MattisLind/68008ice/kicad/BOM.csv

Reference | Quantity | Value | Footprint | Manufacturer | MPN | LCSC | JLCPCB_library | Assembly | JLCPCB_URL | Verified_date | Selection_reason | Source | Status
C1 | 1 | 15p | Capacitor_SMD:C_0402_1005Metric | FH (Guangdong Fenghua Advanced Tech) | 0402CG150J500NT | C1548 | Basic | JLCPCB_SMT | https://jlcpcb.com/partdetail/0402CG150J500NT/C1548 | 2026-11-09 | Basic C0G crystal load capacitors; both use the same part. | https://www.lcsc.com/datasheet/C1548.pdf | candidate
C2 | 1 | 15p | Capacitor_SMD:C_0402_1005Metric | FH (Guangdong Fenghua Advanced Tech) | 0402CG150J500NT | C1548 | Basic | JLCPCB_SMT | https://jlcpcb.com/partdetail/0402CG150J500NT/C1548 | 2026-11-09 | Basic C0G crystal load capacitors; both use the same part. | https://www.lcsc.com/datasheet/C1548.pdf | candidate
C4 | 1 | 10u | Capacitor_SMD:C_0805_2012Metric | Samsu | CL21A106KAYNNNE | C15850 | Basic | JLCPCB_SMT | https://jlcpcb.com/partdetail/CL21A106KAYNNNE/C15850 | 2026-11-09 | Basic 25V X5R for LDO input/output; same exact part. | https://www.lcsc.com/datasheet/C15850.pdf | candidate
C5 | 1 | 10u | Capacitor_SMD:C_0805_2012Metric | Samsu | CL21A106KAYNNNE | C15850 | Basic | JLCPCB_SMT | https://jlcpcb.com/partdetail/CL21A106KAYNNNE/C15850 | 2026-11-09 | Basic 25V X5R for LDO input/output; same exact part. | https://www.lcsc.com/datasheet/C15850.pdf | candidate
C6 | 1 | 4.7u | Capacitor_SMD:C_0402_1005Metric | Samsung Electro-Mechanics | CL05A475MP5NRNC | C23733 | Basic | JLCPCB_SMT | https://jlcpcb.com/partdetail/CL05A475MP5NRNC/C23733 | 2026-11-09 | Basic 10V X5R; share core/filter and PSRAM local bypass value; verify effective capacitance, including at least 1uF at PSRAM VDD. | https://www.lcsc.com/datasheet/C23733.pdf | candidate
C7 | 1 | 4.7u | Capacitor_SMD:C_0402_1005Metric | Samsung Electro-Mechanics | CL05A475MP5NRNC | C23733 | Basic | JLCPCB_SMT | https://jlcpcb.com/partdetail/CL05A475MP5NRNC/C23733 | 2026-11-09 | Basic 10V X5R; share core/filter and PSRAM local bypass value; verify effective capacitance, including at least 1uF at PSRAM VDD. | https://www.lcsc.com/datasheet/C23733.pdf | candidate
C8 | 1 | 4.7u | Capacitor_SMD:C_0402_1005Metric | Samsung Electro-Mechanics | CL05A475MP5NRNC | C23733 | Basic | JLCPCB_SMT | https://jlcpcb.com/partdetail/CL05A475MP5NRNC/C23733 | 2026-11-09 | Basic 10V X5R; share core/filter and PSRAM local bypass value; verify effective capacitance, including at least 1uF at PSRAM VDD. | https://www.lcsc.com/datasheet/C23733.pdf | candidate
C9 | 1 | 100n | Capacitor_SMD:C_0402_1005Metric | Samsung Electro-Mechanics | CL05B104KO5NNNC | C1525 | Basic | JLCPCB_SMT | https://jlcpcb.com/partdetail/CL05B104KO5NNNC/C1525 | 2026-11-09 | Basic common MCU, PSRAM and connector high-frequency bypass part. | https://www.lcsc.com/datasheet/C1525.pdf | candidate
C10 | 1 | 100n | Capacitor_SMD:C_0402_1005Metric | Samsung Electro-Mechanics | CL05B104KO5NNNC | C1525 | Basic | JLCPCB_SMT | https://jlcpcb.com/partdetail/CL05B104KO5NNNC/C1525 | 2026-11-09 | Basic common MCU, PSRAM and connector high-frequency bypass part. | https://www.lcsc.com/datasheet/C1525.pdf | candidate
C11 | 1 | 100n | Capacitor_SMD:C_0402_1005Metric | Samsung Electro-Mechanics | CL05B104KO5NNNC | C1525 | Basic | JLCPCB_SMT | https://jlcpcb.com/partdetail/CL05B104KO5NNNC/C1525 | 2026-11-09 | Basic common MCU, PSRAM and connector high-frequency bypass part. | https://www.lcsc.com/datasheet/C1525.pdf | candidate
C12 | 1 | 100n | Capacitor_SMD:C_0402_1005Metric | Samsung Electro-Mechanics | CL05B104KO5NNNC | C1525 | Basic | JLCPCB_SMT | https://jlcpcb.com/partdetail/CL05B104KO5NNNC/C1525 | 2026-11-09 | Basic common MCU, PSRAM and connector high-frequency bypass part. | https://www.lcsc.com/datasheet/C1525.pdf | candidate
C13 | 1 | 100n | Capacitor_SMD:C_0402_1005Metric | Samsung Electro-Mechanics | CL05B104KO5NNNC | C1525 | Basic | JLCPCB_SMT | https://jlcpcb.com/partdetail/CL05B104KO5NNNC/C1525 | 2026-11-09 | Basic common MCU, PSRAM and connector high-frequency bypass part. | https://www.lcsc.com/datasheet/C1525.pdf | candidate
C14 | 1 | 100n | Capacitor_SMD:C_0402_1005Metric | Samsung Electro-Mechanics | CL05B104KO5NNNC | C1525 | Basic | JLCPCB_SMT | https://jlcpcb.com/partdetail/CL05B104KO5NNNC/C1525 | 2026-11-09 | Basic common MCU, PSRAM and connector high-frequency bypass part. | https://www.lcsc.com/datasheet/C1525.pdf | candidate
C15 | 1 | 100n | Capacitor_SMD:C_0402_1005Metric | Samsung Electro-Mechanics | CL05B104KO5NNNC | C1525 | Basic | JLCPCB_SMT | https://jlcpcb.com/partdetail/CL05B104KO5NNNC/C1525 | 2026-11-09 | Basic common MCU, PSRAM and connector high-frequency bypass part. | https://www.lcsc.com/datasheet/C1525.pdf | candidate
C16 | 1 | 100n | Capacitor_SMD:C_0402_1005Metric | Samsung Electro-Mechanics | CL05B104KO5NNNC | C1525 | Basic | JLCPCB_SMT | https://jlcpcb.com/partdetail/CL05B104KO5NNNC/C1525 | 2026-11-09 | Basic common MCU, PSRAM and connector high-frequency bypass part. | https://www.lcsc.com/datasheet/C1525.pdf | candidate
C17 | 1 | 100n | Capacitor_SMD:C_0402_1005Metric | Samsung Electro-Mechanics | CL05B104KO5NNNC | C1525 | Basic | JLCPCB_SMT | https://jlcpcb.com/partdetail/CL05B104KO5NNNC/C1525 | 2026-11-09 | Basic common MCU, PSRAM and connector high-frequency bypass part. | https://www.lcsc.com/datasheet/C1525.pdf | candidate
C18 | 1 | 100n | Capacitor_SMD:C_0402_1005Metric | Samsung Electro-Mechanics | CL05B104KO5NNNC | C1525 | Basic | JLCPCB_SMT | https://jlcpcb.com/partdetail/CL05B104KO5NNNC/C1525 | 2026-11-09 | Basic common MCU, PSRAM and connector high-frequency bypass part. | https://www.lcsc.com/datasheet/C1525.pdf | candidate
C19 | 1 | 100n | Capacitor_SMD:C_0402_1005Metric | Samsung Electro-Mechanics | CL05B104KO5NNNC | C1525 | Basic | JLCPCB_SMT | https://jlcpcb.com/partdetail/CL05B104KO5NNNC/C1525 | 2026-11-09 | Basic common MCU, PSRAM and connector high-frequency bypass part. | https://www.lcsc.com/datasheet/C1525.pdf | candidate
C20 | 1 | 100n | Capacitor_SMD:C_0402_1005Metric | Samsung Electro-Mechanics | CL05B104KO5NNNC | C1525 | Basic | JLCPCB_SMT | https://jlcpcb.com/partdetail/CL05B104KO5NNNC/C1525 | 2026-11-09 | Basic common MCU, PSRAM and connector high-frequency bypass part. | https://www.lcsc.com/datasheet/C1525.pdf | candidate
C21 | 1 | 100n | Capacitor_SMD:C_0402_1005Metric | Samsung Electro-Mechanics | CL05B104KO5NNNC | C1525 | Basic | JLCPCB_SMT | https://jlcpcb.com/partdetail/CL05B104KO5NNNC/C1525 | 2026-11-09 | Basic common MCU, PSRAM and connector high-frequency bypass part. | https://www.lcsc.com/datasheet/C1525.pdf | candidate
C22 | 1 | 100n | Capacitor_SMD:C_0402_1005Metric | Samsung Electro-Mechanics | CL05B104KO5NNNC | C1525 | Basic | JLCPCB_SMT | https://jlcpcb.com/partdetail/CL05B104KO5NNNC/C1525 | 2026-11-09 | Basic common MCU, PSRAM and connector high-frequency bypass part. | https://www.lcsc.com/datasheet/C1525.pdf | candidate
D1 | 1 | BAT54X | Diode_SMD:D_SOD-523 | R+O | BAT54X | C19627026 | Extended | JLCPCB_SMT | https://jlcpcb.com/partdetail/BAT54X/C19627026 | 2026-11-10 | User-selected Extended SMT R+O BAT54X / C19627026, SOD-523, 30V/200mA. Five identical upper clamps; pad 1 cathode to 3V3, pad 2 anode at the protected MCU node. Retain the accepted sub-mA forward-voltage margin and nominal proxy-model SPICE evidence. | https://datasheet.lcsc.com/datasheet/pdf/cb06a61a226c47be2923522f1be7f66a.pdf?productCode=C19627026 | accepted_BAT54_voltage_margin_risk
D2 | 1 | BAT54X | Diode_SMD:D_SOD-523 | R+O | BAT54X | C19627026 | Extended | JLCPCB_SMT | https://jlcpcb.com/partdetail/BAT54X/C19627026 | 2026-11-10 | User-selected Extended SMT R+O BAT54X / C19627026, SOD-523, 30V/200mA. Five identical upper clamps; pad 1 cathode to 3V3, pad 2 anode at the protected MCU node. Retain the accepted sub-mA forward-voltage margin and nominal proxy-model SPICE evidence. | https://datasheet.lcsc.com/datasheet/pdf/cb06a61a226c47be2923522f1be7f66a.pdf?productCode=C19627026 | accepted_BAT54_voltage_margin_risk
D3 | 1 | BAT54X | Diode_SMD:D_SOD-523 | R+O | BAT54X | C19627026 | Extended | JLCPCB_SMT | https://jlcpcb.com/partdetail/BAT54X/C19627026 | 2026-11-10 | User-selected Extended SMT R+O BAT54X / C19627026, SOD-523, 30V/200mA. Five identical upper clamps; pad 1 cathode to 3V3, pad 2 anode at the protected MCU node. Retain the accepted sub-mA forward-voltage margin and nominal proxy-model SPICE evidence. | https://datasheet.lcsc.com/datasheet/pdf/cb06a61a226c47be2923522f1be7f66a.pdf?productCode=C19627026 | accepted_BAT54_voltage_margin_risk
D4 | 1 | BAT54X | Diode_SMD:D_SOD-523 | R+O | BAT54X | C19627026 | Extended | JLCPCB_SMT | https://jlcpcb.com/partdetail/BAT54X/C19627026 | 2026-11-10 | User-selected Extended SMT R+O BAT54X / C19627026, SOD-523, 30V/200mA. Five identical upper clamps; pad 1 cathode to 3V3, pad 2 anode at the protected MCU node. Retain the accepted sub-mA forward-voltage margin and nominal proxy-model SPICE evidence. | https://datasheet.lcsc.com/datasheet/pdf/cb06a61a226c47be2923522f1be7f66a.pdf?productCode=C19627026 | accepted_BAT54_voltage_margin_risk
D5 | 1 | BAT54X | Diode_SMD:D_SOD-523 | R+O | BAT54X | C19627026 | Extended | JLCPCB_SMT | https://jlcpcb.com/partdetail/BAT54X/C19627026 | 2026-11-10 | User-selected Extended SMT R+O BAT54X / C19627026, SOD-523, 30V/200mA. Five identical upper clamps; pad 1 cathode to 3V3, pad 2 anode at the protected MCU node. Retain the accepted sub-mA forward-voltage margin and nominal proxy-model SPICE evidence. | https://datasheet.lcsc.com/datasheet/pdf/cb06a61a226c47be2923522f1be7f66a.pdf?productCode=C19627026 | accepted_BAT54_voltage_margin_risk
J1 | 1 | CPU TOP SOCKET - MECHANICAL TBD |  | TBD | TBD |  |  | Manual |  |  | Top/bottom DIP contacts assembled manually; excluded from JLCPCB selection. | https://www.nxp.com/docs/en/reference-manual/MC68000UM.pdf | unresolved_connector_no_footprint
J2 | 1 | TARGET BOTTOM PLUG - MECHANICAL TBD |  | TBD | TBD |  |  | Manual |  |  | Top/bottom DIP contacts assembled manually; excluded from JLCPCB selection. | https://www.nxp.com/docs/en/reference-manual/MC68000UM.pdf | unresolved_connector_no_footprint
J3 | 1 | USB4105-GF-A | Connector_USB:USB_C_Receptacle_GCT_USB4105-xx-A_16P_TopMnt_Horizontal | Global Connector Technology | USB4105-GF-A | C3020560 | Extended | JLCPCB_SMT | https://jlcpcb.com/partdetail/USB4105-GF-A/C3020560 | 2026-11-09 | Extended: retain documented USB-C SMT-contact connector/footprint; alternative C165948 is also Extended. Shell stakes require placement review. | https://www.lcsc.com/datasheet/C3020560.pdf | candidate_verify_stake_option
J4 | 1 | SWD JST-SH | Connector_JST:JST_SH_SM03B-SRSS-TB_1x03-1MP_P1.00mm_Horizontal | JST | SM03B-SRSS-TB(LF)(SN) | C160403 | Extended | JLCPCB_SMT | https://jlcpcb.com/partdetail/JST-SM03B_SRSS_TB_LF_SN/C160403 | 2026-11-10 | Extended SMT genuine JST-SH 3-pin 1.0mm-pitch side-entry header, matching the Raspberry Pi Debug Probe supplied cable. Pins 1 SWCLK, 2 GND, 3 SWDIO; metal mounting pads to GND. Selected instead of probe pads; no qualified Basic mating-equivalent was established. Verify board-end cable access and CPU/socket clearance during placement. | https://www.jst-mfg.com/product/pdf/eng/eSH.pdf | candidate_verify_connector_access_and_CPU_clearance
JP1 | 1 | ACTIVE PERMIT - solder bridge open=PASSIVE |  | PCB copper | PCB_FEATURE |  |  | PCB_feature |  |  | PCB copper/pad feature; no purchased component. |  | PCB_solder_bridge_geometry_pending
L1 | 1 | 3.3u AOTA-B201610S3R3-101-T | rp2350_ice:AOTA-B201610S3R3-101-T | Abracon LLC | AOTA-B201610S3R3-101-T | C42411119 | Extended | JLCPCB_SMT | https://jlcpcb.com/partdetail/AOTA-B201610S3R3-101-T/C42411119 | 2026-11-09 | Extended: preserve validated reference core-regulator inductor, current ratings and orientation mark; generic same inductance is insufficient. | https://www.lcsc.com/datasheet/C42411119.pdf | candidate
Q1 | 1 | 2N7002 | Package_TO_SOT_SMD:SOT-23 | Jiangsu Changjing Electronics Technology Co., Ltd. | 2N7002 | C8545 | Basic | JLCPCB_SMT | https://jlcpcb.com/partdetail/2N7002/C8545 | 2026-11-09 | Basic 2N7002 for isolated VBUS presence detection. | https://www.lcsc.com/datasheet/C8545.pdf | candidate
R1 | 1 | 1k | Resistor_SMD:R_0402_1005Metric | UNI-ROYAL(Uniroyal Elec) | 0402WGF1001TCE | C11702 | Basic | JLCPCB_SMT | https://jlcpcb.com/partdetail/0402WGF1001TCE/C11702 | 2026-11-09 | Basic: share crystal/BOOTSEL series, two rail loads and strong PSRAM CS1 pull-up. | https://www.lcsc.com/datasheet/C11702.pdf | candidate
R2 | 1 | 1k | Resistor_SMD:R_0402_1005Metric | UNI-ROYAL(Uniroyal Elec) | 0402WGF1001TCE | C11702 | Basic | JLCPCB_SMT | https://jlcpcb.com/partdetail/0402WGF1001TCE/C11702 | 2026-11-09 | Basic: share crystal/BOOTSEL series, two rail loads and strong PSRAM CS1 pull-up. | https://www.lcsc.com/datasheet/C11702.pdf | candidate
R3 | 1 | 10k | Resistor_SMD:R_0402_1005Metric | UNI-ROYAL(Uniroyal Elec) | 0402WGF1002TCE | C25744 | Basic | JLCPCB_SMT | https://jlcpcb.com/partdetail/0402WGF1002TCE/C25744 | 2026-11-09 | Share RUN pull-up, MODE_PERMIT pull-down, VBUS gate series and detector pull-up. | https://www.lcsc.com/datasheet/C25744.pdf | candidate
R4 | 1 | 1k | Resistor_SMD:R_0402_1005Metric | UNI-ROYAL(Uniroyal Elec) | 0402WGF1001TCE | C11702 | Basic | JLCPCB_SMT | https://jlcpcb.com/partdetail/0402WGF1001TCE/C11702 | 2026-11-09 | Basic: share crystal/BOOTSEL series, two rail loads and strong PSRAM CS1 pull-up. | https://www.lcsc.com/datasheet/C11702.pdf | candidate
R5 | 1 | 10k | Resistor_SMD:R_0402_1005Metric | UNI-ROYAL(Uniroyal Elec) | 0402WGF1002TCE | C25744 | Basic | JLCPCB_SMT | https://jlcpcb.com/partdetail/0402WGF1002TCE/C25744 | 2026-11-09 | Share RUN pull-up, MODE_PERMIT pull-down, VBUS gate series and detector pull-up. | https://www.lcsc.com/datasheet/C25744.pdf | candidate
R6 | 1 | 33 | Resistor_SMD:R_0402_1005Metric | UNI-ROYAL(Uniroyal Elec) | 0402WGF330JTCE | C25105 | Basic | JLCPCB_SMT | https://jlcpcb.com/partdetail/0402WGF330JTCE/C25105 | 2026-11-09 | Basic reference VREG_AVDD filter value; no fee saving justifies changing it to 27 ohm. | https://www.lcsc.com/datasheet/C25105.pdf | candidate
R7 | 1 | 5.1k | Resistor_SMD:R_0402_1005Metric | UNI-ROYAL(Uniroyal Elec) | 0402WGF5101TCE | C25905 | Basic | JLCPCB_SMT | https://jlcpcb.com/partdetail/0402WGF5101TCE/C25905 | 2026-11-09 | Separate USB-C CC Rd resistors; preserve required value. | https://www.lcsc.com/datasheet/C25905.pdf | candidate
R8 | 1 | 5.1k | Resistor_SMD:R_0402_1005Metric | UNI-ROYAL(Uniroyal Elec) | 0402WGF5101TCE | C25905 | Basic | JLCPCB_SMT | https://jlcpcb.com/partdetail/0402WGF5101TCE/C25905 | 2026-11-09 | Separate USB-C CC Rd resistors; preserve required value. | https://www.lcsc.com/datasheet/C25905.pdf | candidate
R9 | 1 | 27 | Resistor_SMD:R_0402_1005Metric | UNI-ROYAL(Uniroyal Elec) | 0402WGF270JTCE | C25100 | Extended | JLCPCB_SMT | https://jlcpcb.com/partdetail/0402WGF270JTCE/C25100 | 2026-11-09 | Extended: keep RP2350 reference USB series termination value; 0603 candidate C25190 is also Extended. Share the exact SKU on D+ and D-. | https://www.lcsc.com/datasheet/C25100.pdf | candidate
R10 | 1 | 27 | Resistor_SMD:R_0402_1005Metric | UNI-ROYAL(Uniroyal Elec) | 0402WGF270JTCE | C25100 | Extended | JLCPCB_SMT | https://jlcpcb.com/partdetail/0402WGF270JTCE/C25100 | 2026-11-09 | Extended: keep RP2350 reference USB series termination value; 0603 candidate C25190 is also Extended. Share the exact SKU on D+ and D-. | https://www.lcsc.com/datasheet/C25100.pdf | candidate
R11 | 1 | 10k | Resistor_SMD:R_0402_1005Metric | UNI-ROYAL(Uniroyal Elec) | 0402WGF1002TCE | C25744 | Basic | JLCPCB_SMT | https://jlcpcb.com/partdetail/0402WGF1002TCE/C25744 | 2026-11-09 | Share RUN pull-up, MODE_PERMIT pull-down, VBUS gate series and detector pull-up. | https://www.lcsc.com/datasheet/C25744.pdf | candidate
R12 | 1 | 100k | Resistor_SMD:R_0402_1005Metric | UNI-ROYAL(Uniroyal Elec) | 0402WGF1003TCE | C25741 | Basic | JLCPCB_SMT | https://jlcpcb.com/partdetail/0402WGF1003TCE/C25741 | 2026-11-09 | VBUS gate pull-down: 10:1 ratio with existing 10k maintains MOSFET gate drive. | https://www.lcsc.com/datasheet/C25741.pdf | candidate
R13 | 1 | 10k | Resistor_SMD:R_0402_1005Metric | UNI-ROYAL(Uniroyal Elec) | 0402WGF1002TCE | C25744 | Basic | JLCPCB_SMT | https://jlcpcb.com/partdetail/0402WGF1002TCE/C25744 | 2026-11-09 | Share RUN pull-up, MODE_PERMIT pull-down, VBUS gate series and detector pull-up. | https://www.lcsc.com/datasheet/C25744.pdf | candidate
R14 | 1 | 2.2k | Resistor_SMD:R_0402_1005Metric | UNI-ROYAL(Uniroyal Elec) | 0402WGF2201TCE | C25879 | Basic | JLCPCB_SMT | https://jlcpcb.com/partdetail/0402WGF2201TCE/C25879 | 2026-11-09 | Common value for all five clamp series resistors. | https://www.lcsc.com/datasheet/C25879.pdf | candidate
R15 | 1 | 2.2k | Resistor_SMD:R_0402_1005Metric | UNI-ROYAL(Uniroyal Elec) | 0402WGF2201TCE | C25879 | Basic | JLCPCB_SMT | https://jlcpcb.com/partdetail/0402WGF2201TCE/C25879 | 2026-11-09 | Common value for all five clamp series resistors. | https://www.lcsc.com/datasheet/C25879.pdf | candidate
R16 | 1 | 2.2k | Resistor_SMD:R_0402_1005Metric | UNI-ROYAL(Uniroyal Elec) | 0402WGF2201TCE | C25879 | Basic | JLCPCB_SMT | https://jlcpcb.com/partdetail/0402WGF2201TCE/C25879 | 2026-11-09 | Common value for all five clamp series resistors. | https://www.lcsc.com/datasheet/C25879.pdf | candidate
R17 | 1 | 2.2k | Resistor_SMD:R_0402_1005Metric | UNI-ROYAL(Uniroyal Elec) | 0402WGF2201TCE | C25879 | Basic | JLCPCB_SMT | https://jlcpcb.com/partdetail/0402WGF2201TCE/C25879 | 2026-11-09 | Common value for all five clamp series resistors. | https://www.lcsc.com/datasheet/C25879.pdf | candidate
R18 | 1 | 2.2k | Resistor_SMD:R_0402_1005Metric | UNI-ROYAL(Uniroyal Elec) | 0402WGF2201TCE | C25879 | Basic | JLCPCB_SMT | https://jlcpcb.com/partdetail/0402WGF2201TCE/C25879 | 2026-11-09 | Common value for all five clamp series resistors. | https://www.lcsc.com/datasheet/C25879.pdf | candidate
R19 | 1 | 1k | Resistor_SMD:R_0402_1005Metric | UNI-ROYAL(Uniroyal Elec) | 0402WGF1001TCE | C11702 | Basic | JLCPCB_SMT | https://jlcpcb.com/partdetail/0402WGF1001TCE/C11702 | 2026-11-09 | Basic: share crystal/BOOTSEL series, two rail loads and strong PSRAM CS1 pull-up. | https://www.lcsc.com/datasheet/C11702.pdf | candidate
R20 | 1 | 1k | Resistor_SMD:R_0402_1005Metric | UNI-ROYAL(Uniroyal Elec) | 0402WGF1001TCE | C11702 | Basic | JLCPCB_SMT | https://jlcpcb.com/partdetail/0402WGF1001TCE/C11702 | 2026-11-09 | Basic: share crystal/BOOTSEL series, two rail loads and strong PSRAM CS1 pull-up. | https://www.lcsc.com/datasheet/C11702.pdf | candidate
SW1 | 1 | BOOTSEL | Button_Switch_SMD:SW_SPST_TS-1088-xR020 | XUNPU | TS-1088-AR02016 | C720477 | Basic | JLCPCB_SMT | https://jlcpcb.com/partdetail/TS-1088-AR02016/C720477 | 2026-11-09 | Basic: replace both Wurth buttons with the same two-pad SMT switch. | https://www.lcsc.com/datasheet/C720477.pdf | selected_SMT_check_height
SW2 | 1 | RUN reset | Button_Switch_SMD:SW_SPST_TS-1088-xR020 | XUNPU | TS-1088-AR02016 | C720477 | Basic | JLCPCB_SMT | https://jlcpcb.com/partdetail/TS-1088-AR02016/C720477 | 2026-11-09 | Basic: replace both Wurth buttons with the same two-pad SMT switch. | https://www.lcsc.com/datasheet/C720477.pdf | selected_SMT_check_height
U1 | 1 | RP2354B (A4 or later) | Package_DFN_QFN:QFN-80-1EP_10x10mm_P0.4mm_EP3.4x3.4mm | Raspberry Pi | RP2354B | C39843328 | Extended | JLCPCB_SMT | https://jlcpcb.com/partdetail/RP2354B/C39843328 | 2026-11-09 | Extended: required 48-GPIO MCU with in-package flash; confirm supplied silicon stepping. | https://www.lcsc.com/datasheet/C39843328.pdf | candidate_verify_orderable_stepping
U2 | 1 | TLV75533PDBVR | Package_TO_SOT_SMD:SOT-23-5 | Texas Instruments | TLV75533PDBVR | C404027 | Extended | JLCPCB_SMT | https://jlcpcb.com/partdetail/TLV75533PDBVR/C404027 | 2026-11-09 | Extended: retain compact 500mA, 1%-accuracy, ceramic-stable reference choice. No qualified Basic drop-in was established in this review; one 3.3V regulator type is used. | https://www.lcsc.com/datasheet/C404027.pdf | candidate
U4 | 1 | TPD2EUSB30ADRTR | Package_TO_SOT_SMD:Texas_DRT-3 | Texas Instruments | TPD2EUSB30ADRTR | C94934 | Extended | JLCPCB_SMT | https://jlcpcb.com/partdetail/TPD2EUSB30ADRTR/C94934 | 2026-11-09 | Extended: low-capacitance ground-referenced ESD array avoids an extra clamp path to the supply. Alternative C7519 is also Extended and not equivalent. | https://www.lcsc.com/datasheet/C94934.pdf | candidate
Y1 | 1 | 12MHz ABM8-272-T3 | Crystal:Crystal_SMD_3225-4Pin_3.2x2.5mm | Abracon LLC | ABM8-272-T3 | C20625731 | Extended | JLCPCB_SMT | https://jlcpcb.com/partdetail/ABM8-272-T3/C20625731 | 2026-11-09 | Extended: reference 12MHz, 10pF, 50-ohm ESR part; Basic C9002 is 20pF/80-ohm and is not a drop-in replacement. | https://www.lcsc.com/datasheet/C20625731.pdf | candidate
C23 | 1 | 100n | Capacitor_SMD:C_0402_1005Metric | Samsung Electro-Mechanics | CL05B104KO5NNNC | C1525 | Basic | JLCPCB_SMT | https://jlcpcb.com/partdetail/CL05B104KO5NNNC/C1525 | 2026-11-09 | Basic common MCU, PSRAM and connector high-frequency bypass part. | https://www.lcsc.com/datasheet/C1525.pdf | shared_J1_J2_pass_through_decoupling_fit_once
U5 | 1 | APS6404L-3SQR-ZR (8 MiB) | Package_SON:Winbond_USON-8-1EP_3x2mm_P0.5mm_EP0.2x1.6mm | AP Memory | APS6404L-3SQR-ZR | C3040877 | Extended | JLCPCB_SMT | https://jlcpcb.com/partdetail/APMemory-APS6404L_3SQRZR/C3040877 | 2026-11-10 | Extended SMT: 64 Mbit / 8 MiB, 2.7-3.6 V SPI/QPI PSRAM; compact 3x2 mm USON package for the DIP adapter. No suitable Basic 8 MiB PSRAM was identified. Shared QSPI data/clock and separate GPIO47 QMI CS1; reuse existing capacitor and pull-up resistor SKUs. Stock/prices require order-time verification. | https://www.pjrc.com/store/APS6404L_3SQR.pdf | candidate_verify_PSRAM_startup_timing_and_layout
C24 | 1 | 4.7u | Capacitor_SMD:C_0402_1005Metric | Samsung Electro-Mechanics | CL05A475MP5NRNC | C23733 | Basic | JLCPCB_SMT | https://jlcpcb.com/partdetail/CL05A475MP5NRNC/C23733 | 2026-11-09 | Basic 10V X5R; share core/filter and PSRAM local bypass value; verify effective capacitance, including at least 1uF at PSRAM VDD. | https://www.lcsc.com/datasheet/C23733.pdf | candidate_effective_capacitance_at_least_1uF
C25 | 1 | 100n | Capacitor_SMD:C_0402_1005Metric | Samsung Electro-Mechanics | CL05B104KO5NNNC | C1525 | Basic | JLCPCB_SMT | https://jlcpcb.com/partdetail/CL05B104KO5NNNC/C1525 | 2026-11-09 | Basic common MCU, PSRAM and connector high-frequency bypass part. | https://www.lcsc.com/datasheet/C1525.pdf | candidate
TBD_OUTPUT_INTERLOCK |  | Independent hardware prevention of active drive in passive mode |  | TBD | TBD |  |  | Unresolved |  |  |  |  | NOT_IMPLEMENTED_NOT_COSTED
