MattisLind/68008ice/simulations/bat54/results/results.csv

case | temp_C | source_V | rail_V | resistor_ohm | current_mA | Vf_V | node_V
forced_current | -20 |  |  |  | 0.1 | 0.21416624405949192 | 0.21416624405949192
forced_current | -20 |  |  |  | 0.5 | 0.25363279844436476 | 0.25363279844436476
forced_current | -20 |  |  |  | 0.7727272727272726 | 0.26496311772208025 | 0.26496311772208025
forced_current | -20 |  |  |  | 1.0 | 0.27190482711453 | 0.27190482711453
nominal_resistor | -20 | 5.0 | 3.3 | 2200 | 0.6542788209950438 | 0.260586593810904 | 3.560586593810904
supply_resistor_corner | -20 | 5.25 | 3.234 | 2178 | 0.8034880726103432 | 0.26600297785467264 | 3.5000029778546726
forced_current | 0 |  |  |  | 0.1 | 0.1816953323746692 | 0.1816953323746692
forced_current | 0 |  |  |  | 0.5 | 0.2241913075115255 | 0.2241913075115255
forced_current | 0 |  |  |  | 0.7727272727272726 | 0.23636983568224976 | 0.23636983568224976
forced_current | 0 |  |  |  | 1.0 | 0.2438218371008838 | 0.2438218371008838
nominal_resistor | 0 | 5.0 | 3.3 | 2200 | 0.667173702353045 | 0.23221785482330137 | 3.532217854823301
supply_resistor_corner | 0 | 5.25 | 3.234 | 2178 | 0.8163714970517787 | 0.23794287942122594 | 3.471942879421226
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
