MattisLind/68008ice/kicad/rp2350_68008_ice.pdf

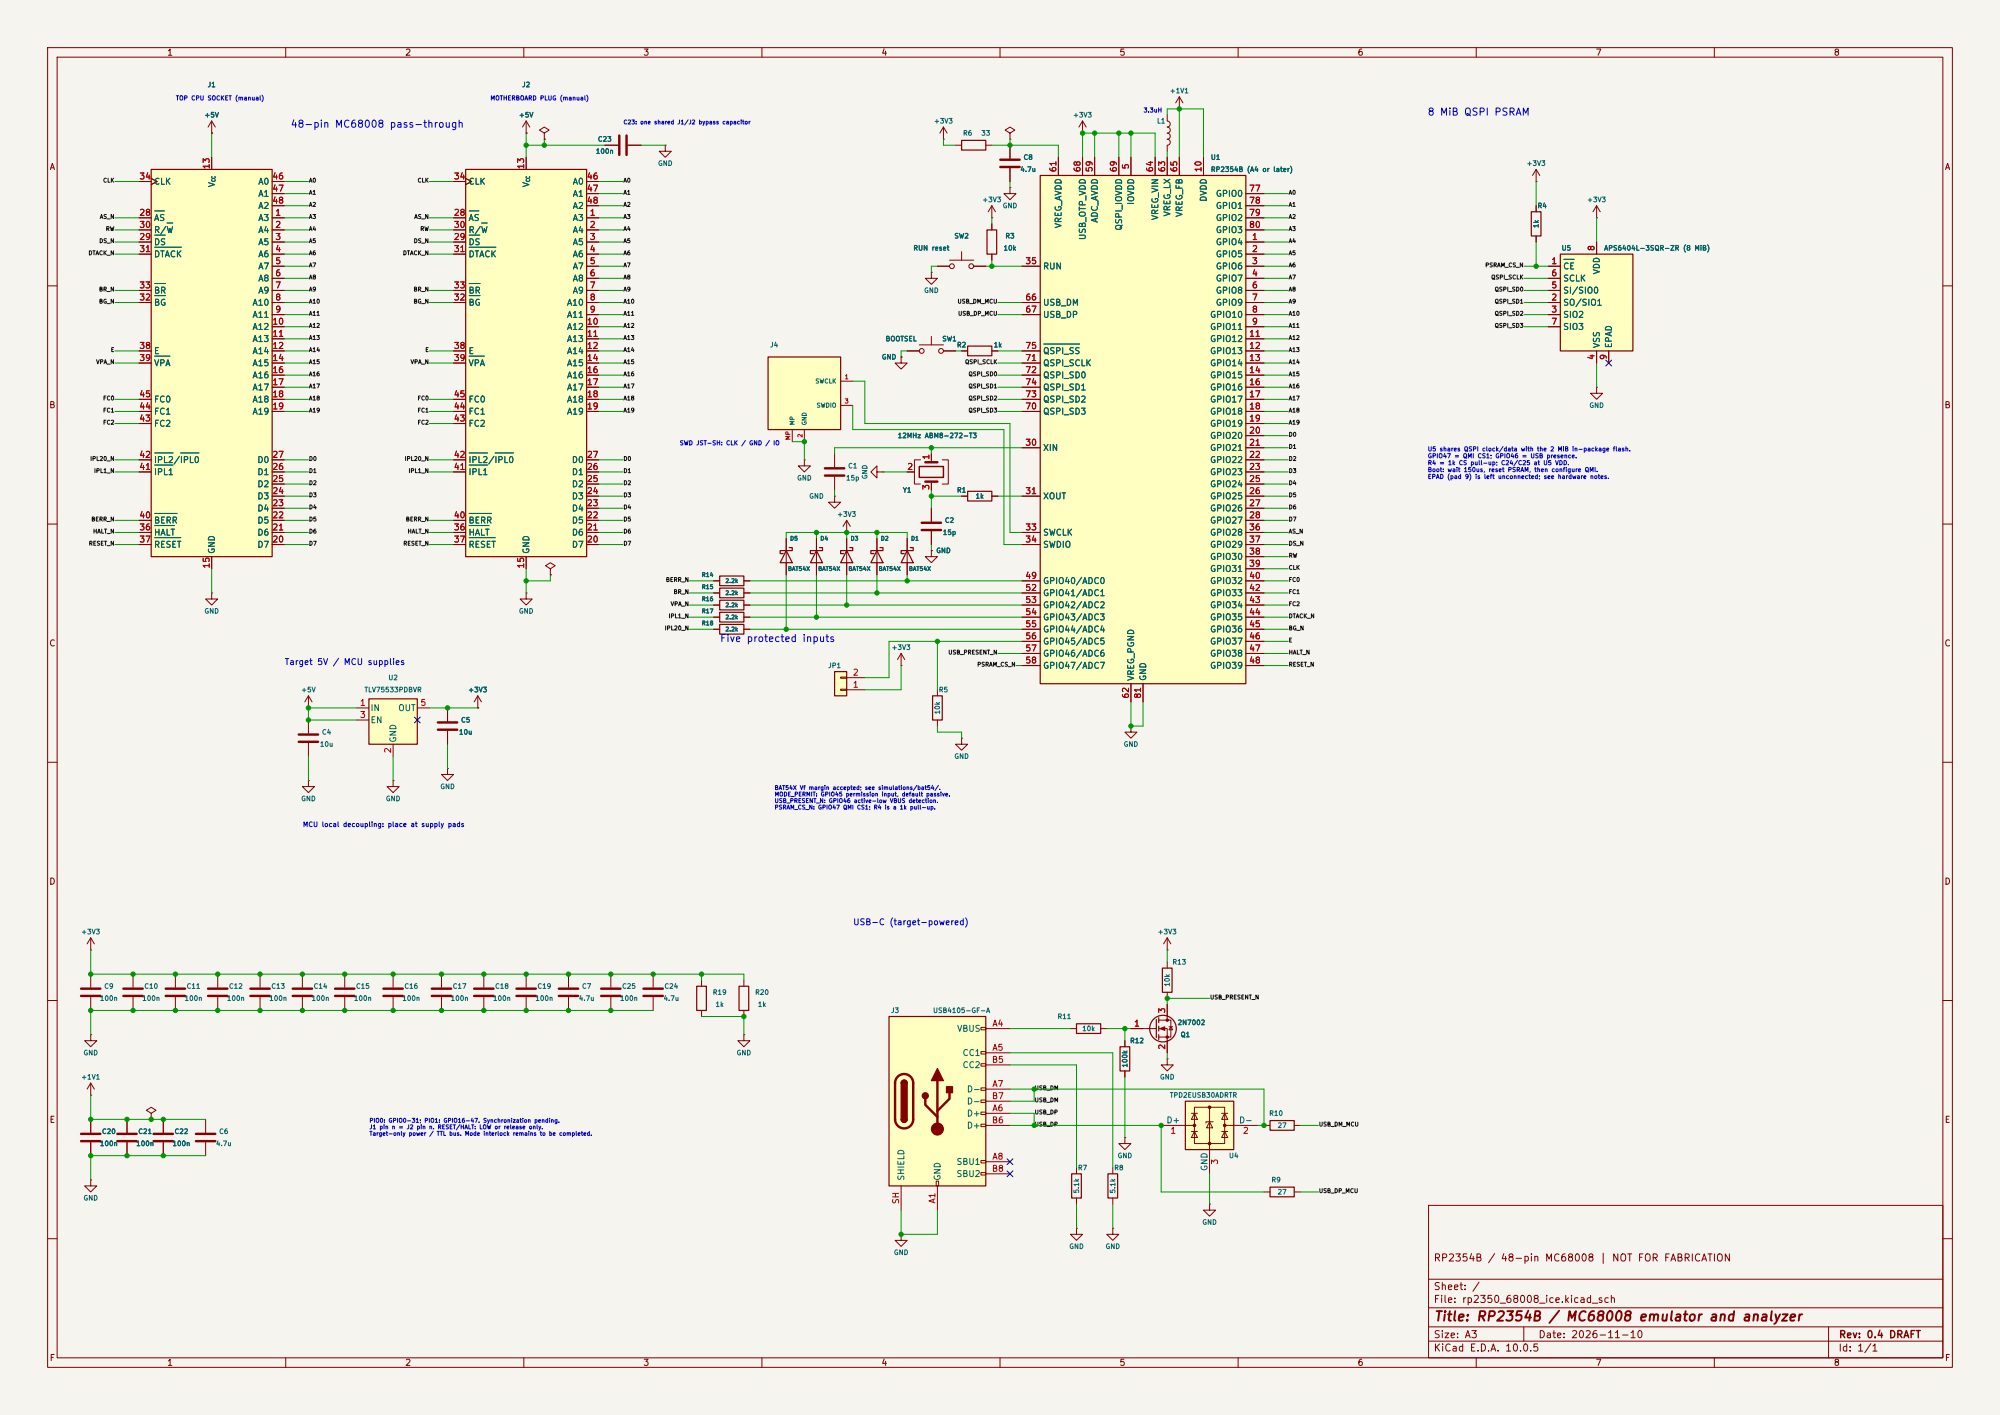
[picture p1: page 1]

30 DTACK 31 BG 32 BR 33 CLK 34 HALT 36 RESET 37

L1 GND

U5 shares QSPI clock/data with the 2 MiB in-package flash. GPIO47 = QMI CS1; GPIO46 = USB presence. R4 = 1k CS pull-up; C24/C25 at U5 VDD. Boot: wait 150us, reset PSRAM, then configure QMI. EPAD (pad 9) is left unconnected; see hardware notes.

USB_DM_MCU MCU local decoupling: place at supply pads

RP2354B / 48-pin MC68008 | NOT FOR FABRICATION

Sheet: /
File: rp2350_68008_ice.kicad_sch
Title: RP2354B / MC68008 emulator and analyzer

Size: A3 | Rev: 0.4 DRAFT | F Date: 2026-11-10
KiCad E.D.A. 10.0.5 | Id: 1/1
