MattisLind/68008ice/kicad/rp2350_68008_ice.kicad_sch

## KiCad design kicad/rp2350_68008_ice.kicad_sch (2026-11-10)

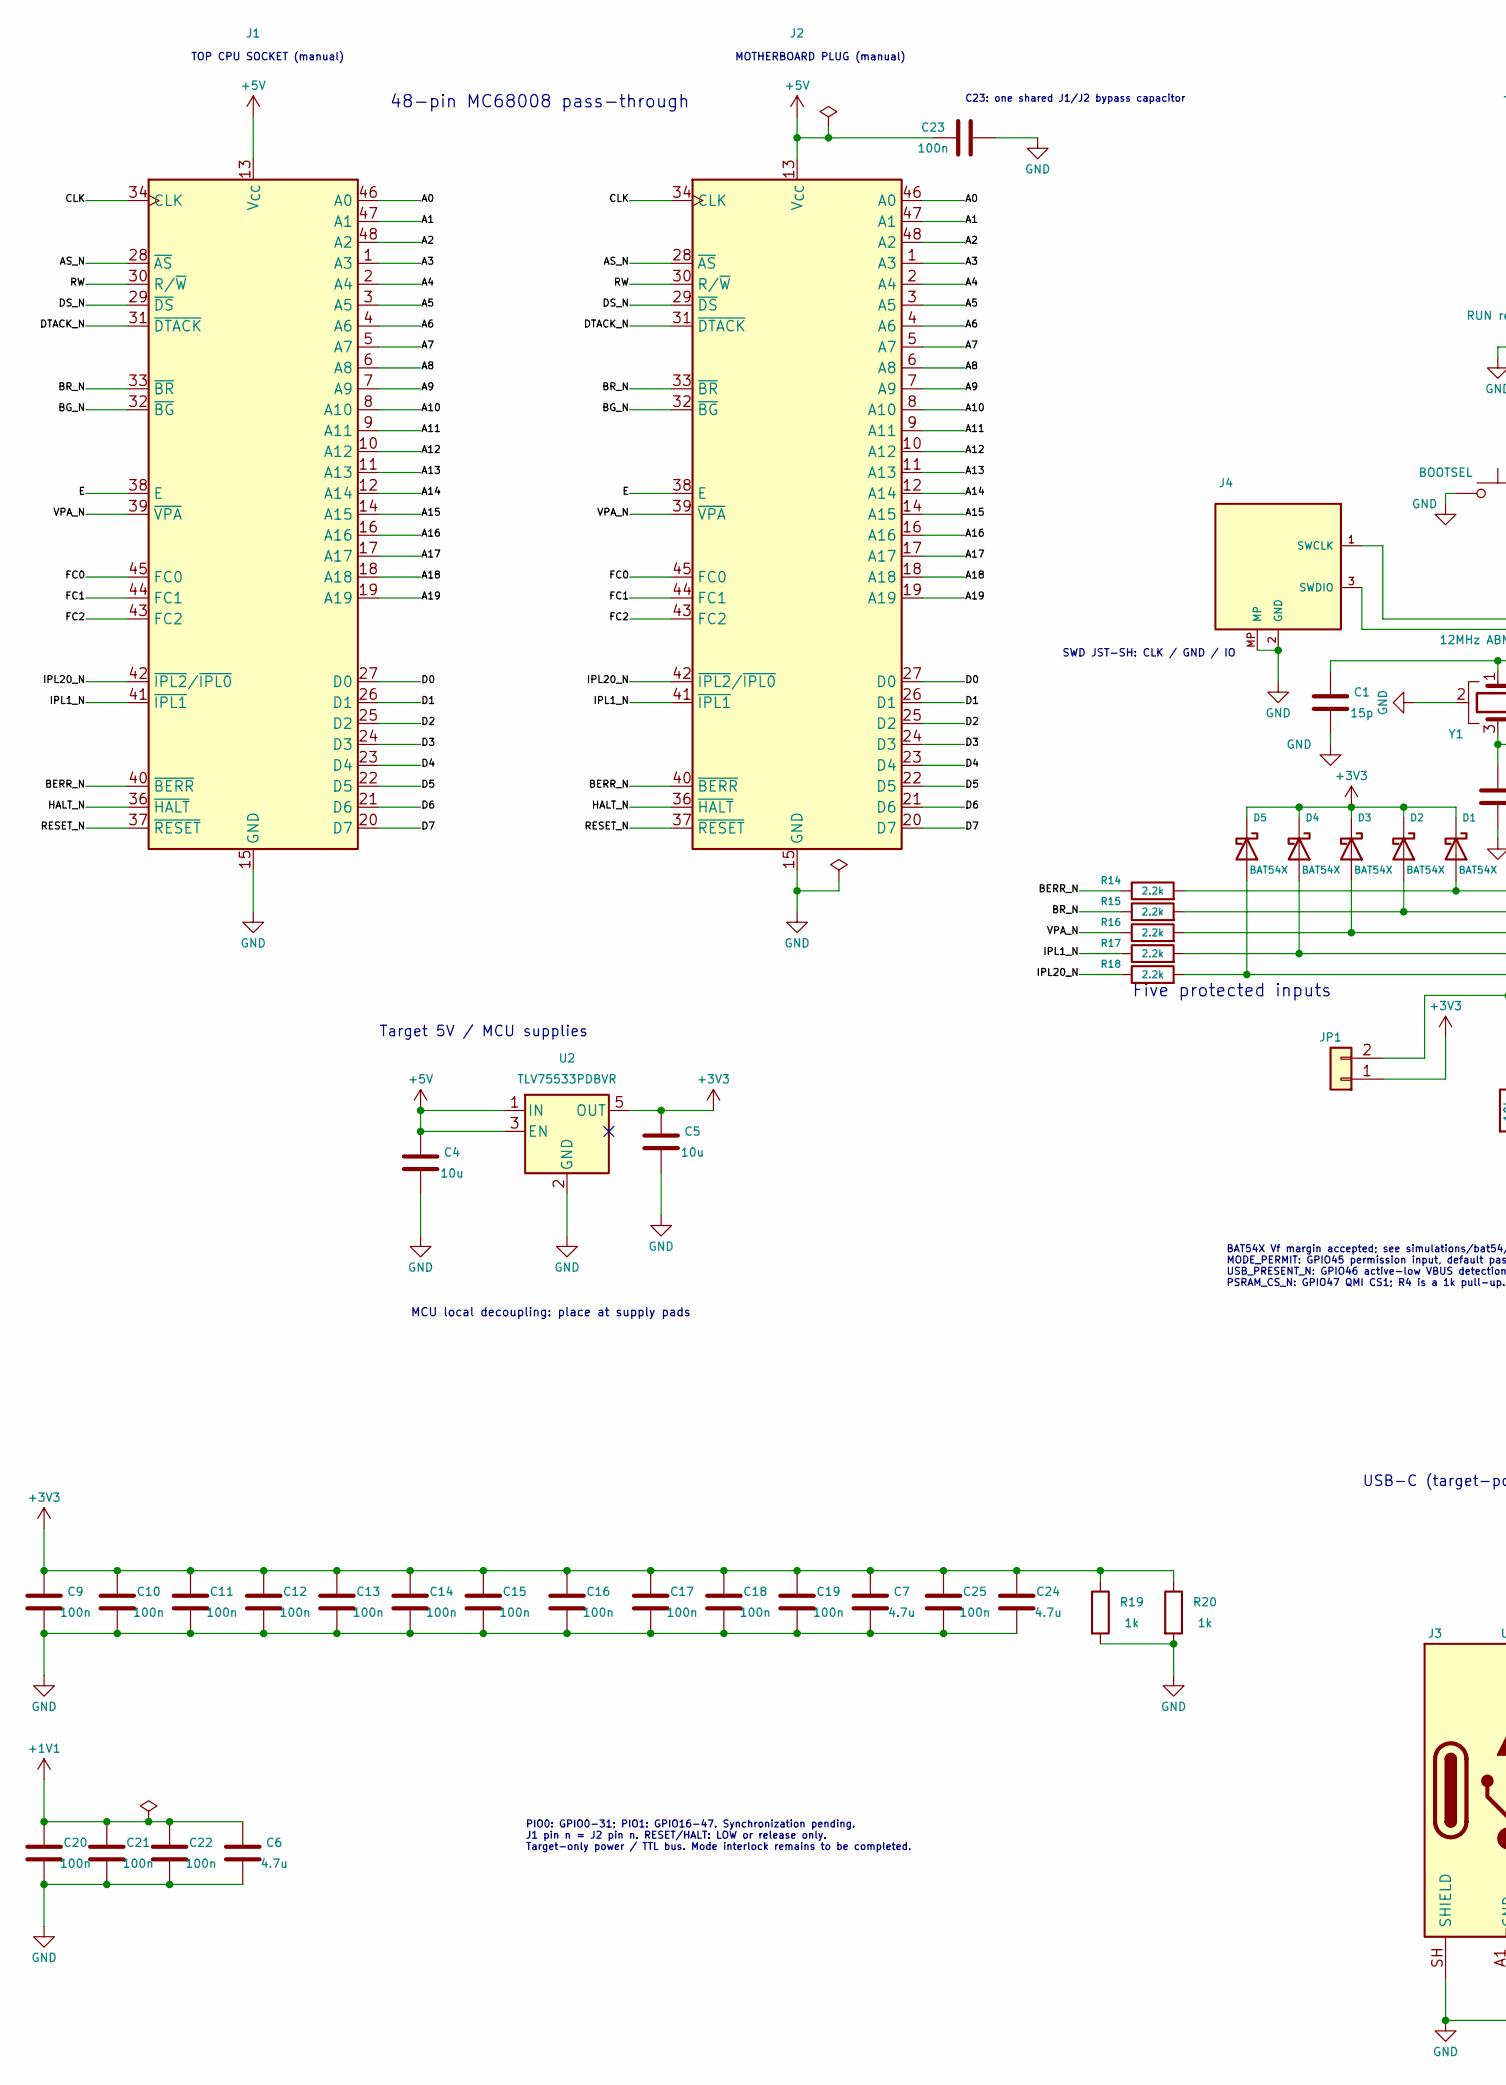
[picture p2: schematic rp2350_68008_ice.kicad_sch, part in row 1, column 1]

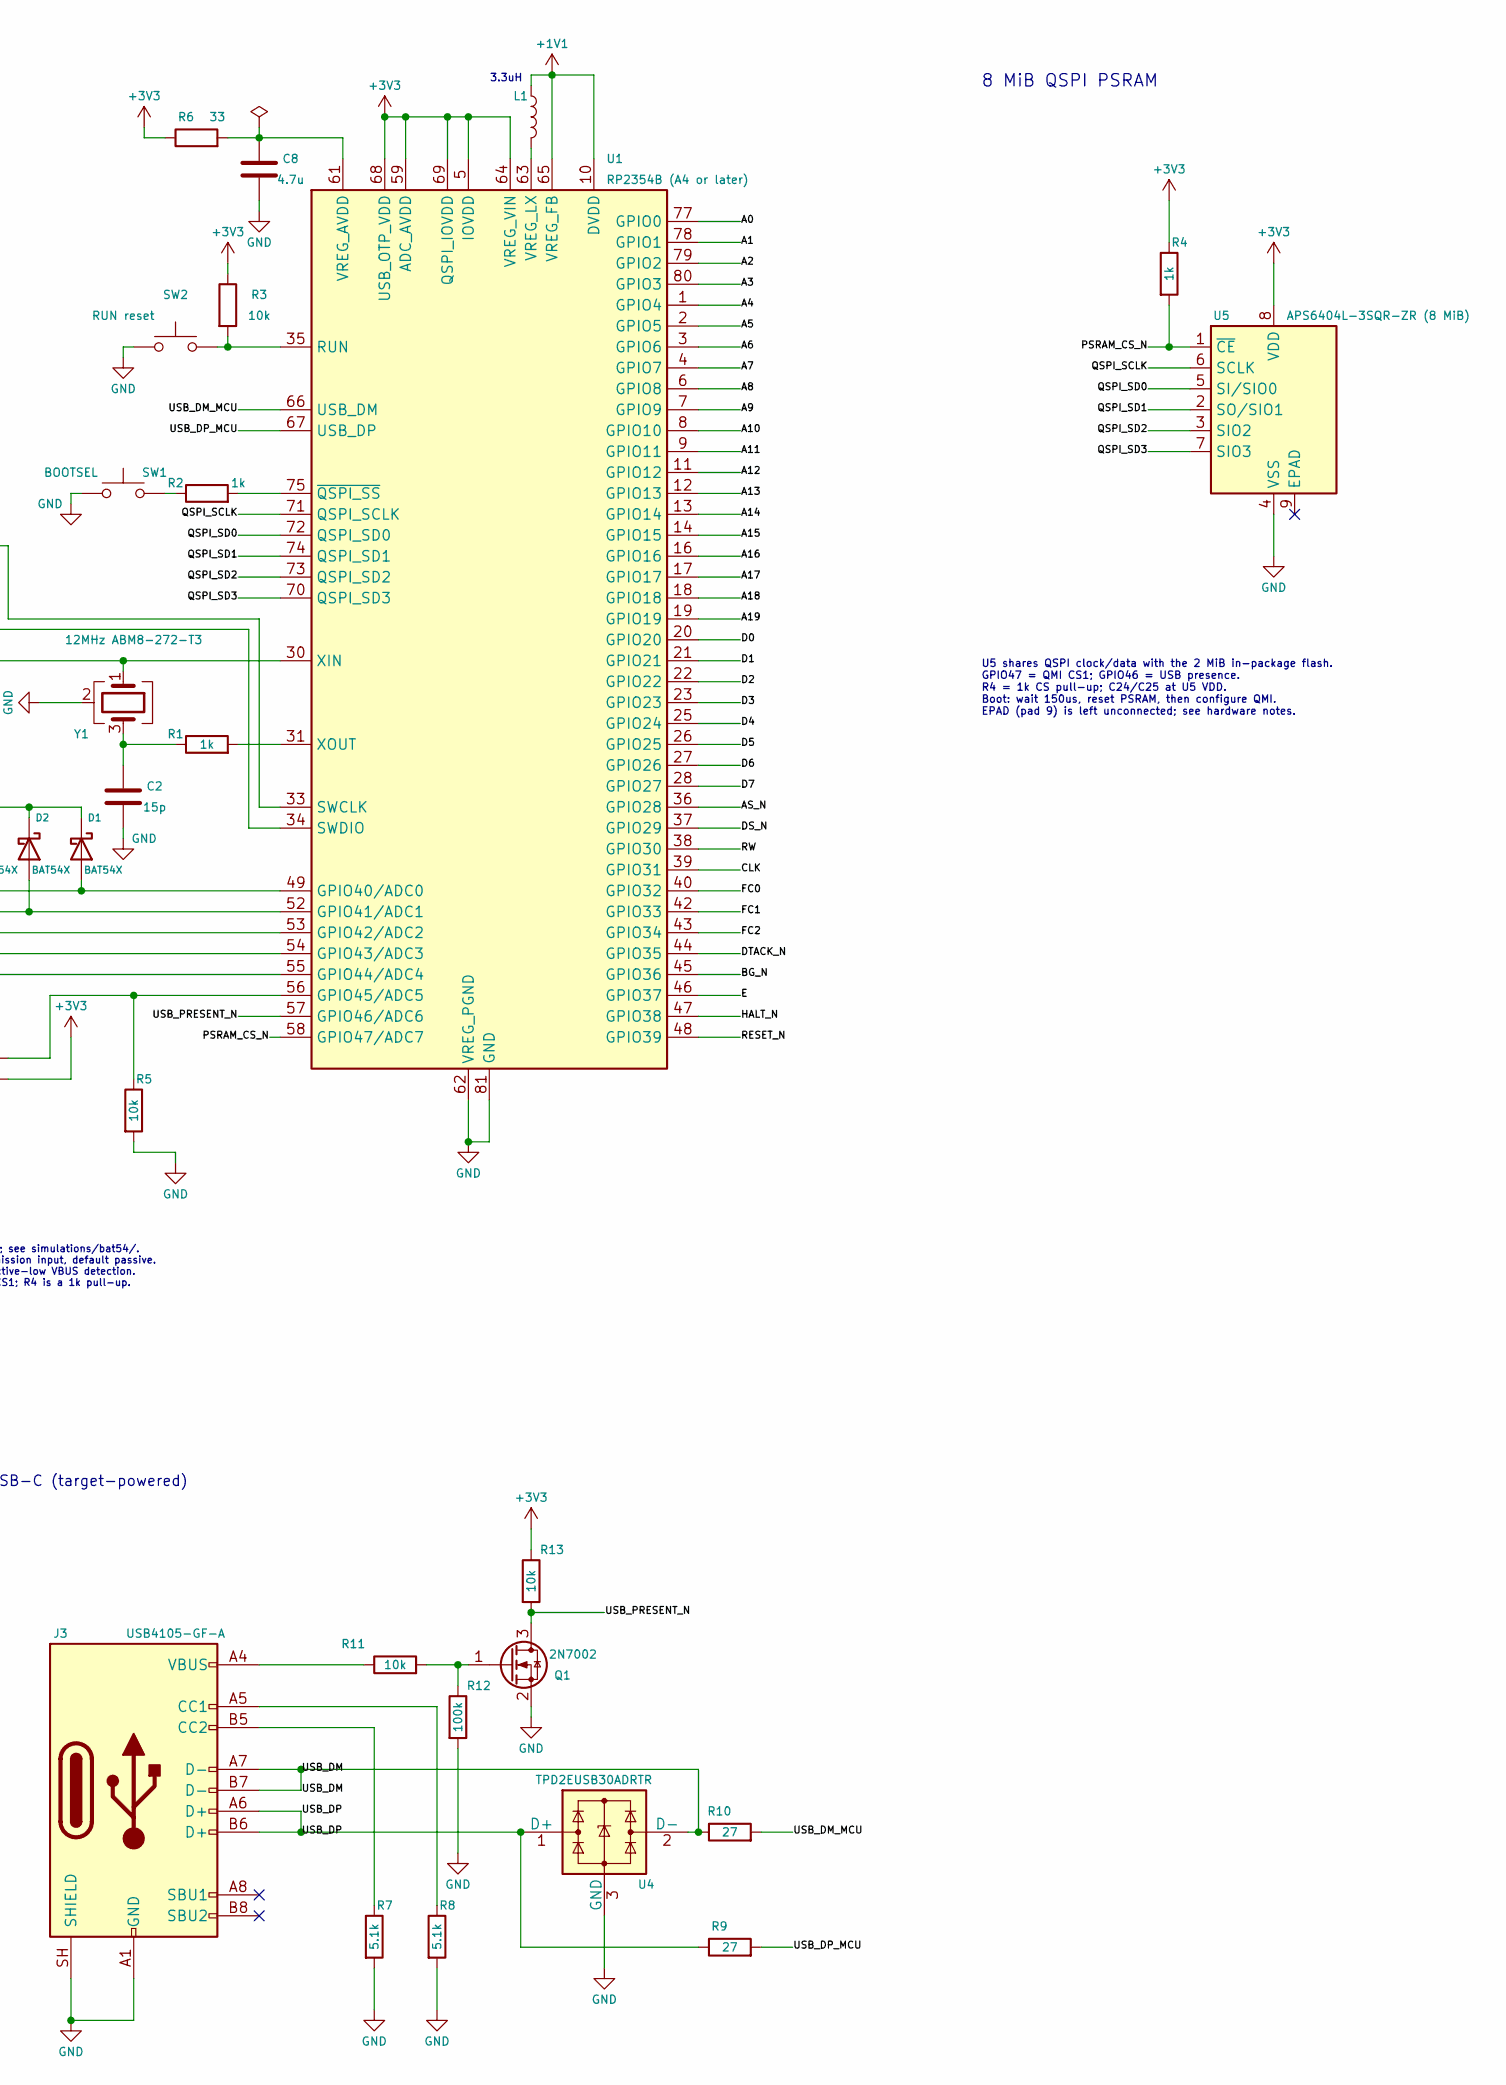
[picture p3: schematic rp2350_68008_ice.kicad_sch, part in row 1, column 2]

Parts:
C1, C2: 15p; C_0402_1005Metric; MPN 0402CG150J500NT; LCSC C1548
C4, C5: 10u; C_0805_2012Metric; MPN CL21A106KAYNNNE; LCSC C15850
C6, C7, C8, C24: 4.7u; C_0402_1005Metric; MPN CL05A475MP5NRNC; LCSC C23733
C9, C10, C11, C12, C13, C14, C15, C16, C17, C18, C19, C20, C21, C22, C23, C25: 100n; C_0402_1005Metric; MPN CL05B104KO5NNNC; LCSC C1525
D1, D2, D3, D4, D5: BAT54X; D_SOD-523; MPN BAT54X; LCSC C19627026
J1: CPU TOP SOCKET - MECHANICAL TBD; MPN TBD
J2: TARGET BOTTOM PLUG - MECHANICAL TBD; MPN TBD
J3: USB4105-GF-A; USB_C_Receptacle_GCT_USB4105-xx-A_16P_TopMnt_Horizontal; MPN USB4105-GF-A; LCSC C3020560
J4: SWD JST-SH; JST_SH_SM03B-SRSS-TB_1x03-1MP_P1.00mm_Horizontal; MPN SM03B-SRSS-TB(LF)(SN); LCSC C160403
JP1: ACTIVE PERMIT - solder bridge open=PASSIVE; MPN PCB_FEATURE
L1: 3.3u AOTA-B201610S3R3-101-T; AOTA-B201610S3R3-101-T; MPN AOTA-B201610S3R3-101-T; LCSC C42411119
Q1: 2N7002; SOT-23; MPN 2N7002; LCSC C8545
R1, R2, R4, R19, R20: 1k; R_0402_1005Metric; MPN 0402WGF1001TCE; LCSC C11702
R3, R5, R11, R13: 10k; R_0402_1005Metric; MPN 0402WGF1002TCE; LCSC C25744
R6: 33; R_0402_1005Metric; MPN 0402WGF330JTCE; LCSC C25105
R7, R8: 5.1k; R_0402_1005Metric; MPN 0402WGF5101TCE; LCSC C25905
R9, R10: 27; R_0402_1005Metric; MPN 0402WGF270JTCE; LCSC C25100
R12: 100k; R_0402_1005Metric; MPN 0402WGF1003TCE; LCSC C25741
R14, R15, R16, R17, R18: 2.2k; R_0402_1005Metric; MPN 0402WGF2201TCE; LCSC C25879
SW1: BOOTSEL; SW_SPST_TS-1088-xR020; MPN TS-1088-AR02016; LCSC C720477
SW2: RUN reset; SW_SPST_TS-1088-xR020; MPN TS-1088-AR02016; LCSC C720477
U1: RP2354B (A4 or later); QFN-80-1EP_10x10mm_P0.4mm_EP3.4x3.4mm; MPN RP2354B; LCSC C39843328
U2: TLV75533PDBVR; SOT-23-5; MPN TLV75533PDBVR; LCSC C404027
U4: TPD2EUSB30ADRTR; Texas_DRT-3; MPN TPD2EUSB30ADRTR; LCSC C94934
U5: APS6404L-3SQR-ZR (8 MiB); Winbond_USON-8-1EP_3x2mm_P0.5mm_EP0.2x1.6mm; MPN APS6404L-3SQR-ZR; LCSC C3040877
Y1: 12MHz ABM8-272-T3; Crystal_SMD_3225-4Pin_3.2x2.5mm; MPN ABM8-272-T3; LCSC C20625731

Connections:
+1V1: C6.1, C20.1, C21.1, C22.1, L1.1, U1.10 (DVDD), U1.32 (DVDD), U1.51 (DVDD), U1.65 (VREG_FB)
+3V3: C5.1, C7.1, C9.1, C10.1, C11.1, C12.1, C13.1, C14.1, C15.1, C16.1, C17.1, C18.1, C19.1, C24.1, C25.1, D1.1 (K), D2.1 (K), D3.1 (K), D4.1 (K), D5.1 (K), JP1.1, R3.1, R4.1, R6.1, R13.1, R19.1, R20.1, U1.5 (IOVDD), U1.15 (IOVDD), U1.24 (IOVDD), U1.29 (IOVDD), U1.41 (IOVDD), U1.50 (IOVDD), U1.59 (ADC_AVDD), U1.60 (IOVDD), U1.64 (VREG_VIN), U1.68 (USB_OTP_VDD), U1.69 (QSPI_IOVDD), U1.76 (IOVDD), U2.5 (OUT), U5.8 (VDD)
+5V: C4.1, C23.1, J1.13 (V_{CC}), J2.13 (V_{CC}), U2.1 (IN), U2.3 (EN)
A0: J1.46 (A0), J2.46 (A0), U1.77 (GPIO0)
A1: J1.47 (A1), J2.47 (A1), U1.78 (GPIO1)
A2: J1.48 (A2), J2.48 (A2), U1.79 (GPIO2)
A3: J1.1 (A3), J2.1 (A3), U1.80 (GPIO3)
A4: J1.2 (A4), J2.2 (A4), U1.1 (GPIO4)
A5: J1.3 (A5), J2.3 (A5), U1.2 (GPIO5)
A6: J1.4 (A6), J2.4 (A6), U1.3 (GPIO6)
A7: J1.5 (A7), J2.5 (A7), U1.4 (GPIO7)
A8: J1.6 (A8), J2.6 (A8), U1.6 (GPIO8)
A9: J1.7 (A9), J2.7 (A9), U1.7 (GPIO9)
A10: J1.8 (A10), J2.8 (A10), U1.8 (GPIO10)
A11: J1.9 (A11), J2.9 (A11), U1.9 (GPIO11)
A12: J1.10 (A12), J2.10 (A12), U1.11 (GPIO12)
A13: J1.11 (A13), J2.11 (A13), U1.12 (GPIO13)
A14: J1.12 (A14), J2.12 (A14), U1.13 (GPIO14)
A15: J1.14 (A15), J2.14 (A15), U1.14 (GPIO15)
A16: J1.16 (A16), J2.16 (A16), U1.16 (GPIO16)
A17: J1.17 (A17), J2.17 (A17), U1.17 (GPIO17)
A18: J1.18 (A18), J2.18 (A18), U1.18 (GPIO18)
A19: J1.19 (A19), J2.19 (A19), U1.19 (GPIO19)
AS_N: J1.28 (~AS), J2.28 (~AS), U1.36 (GPIO28)
BERR_N: J1.40 (~BERR), J2.40 (~BERR), R14.1
BG_N: J1.32 (~BG), J2.32 (~BG), U1.45 (GPIO36)
BR_N: J1.33 (~BR), J2.33 (~BR), R15.1
CLK: J1.34 (CLK), J2.34 (CLK), U1.39 (GPIO31)
D0: J1.27 (D0), J2.27 (D0), U1.20 (GPIO20)
D1: J1.26 (D1), J2.26 (D1), U1.21 (GPIO21)
D2: J1.25 (D2), J2.25 (D2), U1.22 (GPIO22)
D3: J1.24 (D3), J2.24 (D3), U1.23 (GPIO23)
D4: J1.23 (D4), J2.23 (D4), U1.25 (GPIO24)
D5: J1.22 (D5), J2.22 (D5), U1.26 (GPIO25)
D6: J1.21 (D6), J2.21 (D6), U1.27 (GPIO26)
D7: J1.20 (D7), J2.20 (D7), U1.28 (GPIO27)
DS_N: J1.29 (~DS), J2.29 (~DS), U1.37 (GPIO29)
DTACK_N: J1.31 (~DTACK), J2.31 (~DTACK), U1.44 (GPIO35)
E: J1.38 (E), J2.38 (E), U1.46 (GPIO37)
FC0: J1.45 (FC0), J2.45 (FC0), U1.40 (GPIO32)
FC1: J1.44 (FC1), J2.44 (FC1), U1.42 (GPIO33)
FC2: J1.43 (FC2), J2.43 (FC2), U1.43 (GPIO34)
GND: C1.2, C2.2, C4.2, C5.2, C6.2, C7.2, C8.2, C9.2, C10.2, C11.2, C12.2, C13.2, C14.2, C15.2, C16.2, C17.2, C18.2, C19.2, C20.2, C21.2, C22.2, C23.2, C24.2, C25.2, J1.15 (GND), J1.35 (GND), J2.15 (GND), J2.35 (GND), J3.A1 (GND), J3.A12 (GND), J3.B1 (GND), J3.B12 (GND), J3.SH (SHIELD), J4.2 (GND), J4.MP, Q1.2 (S), R5.2, R7.2, R8.2, R12.2, R19.2, R20.2, SW1.1, SW2.1, U1.62 (VREG_PGND), U1.81 (GND), U2.2 (GND), U4.3 (GND), U5.4 (VSS), Y1.2 (G), Y1.4 (G)
HALT_N: J1.36 (~HALT), J2.36 (~HALT), U1.47 (GPIO38)
IPL1_N: J1.41 (~IPL1), J2.41 (~IPL1), R17.1
IPL20_N: J1.42 (~IPL2/~IPL0), J2.42 (~IPL2/~IPL0), R18.1
unnamed: C1.1, U1.30 (XIN), Y1.1
unnamed: C2.1, R1.1, Y1.3
unnamed: C8.1, R6.2, U1.61 (VREG_AVDD)
unnamed: D1.2 (A), R14.2, U1.49 (GPIO40/ADC0)
unnamed: D2.2 (A), R15.2, U1.52 (GPIO41/ADC1)
unnamed: D3.2 (A), R16.2, U1.53 (GPIO42/ADC2)
unnamed: D4.2 (A), R17.2, U1.54 (GPIO43/ADC3)
unnamed: D5.2 (A), R18.2, U1.55 (GPIO44/ADC4)
unnamed: J3.A4 (VBUS), J3.A9 (VBUS), J3.B4 (VBUS), J3.B9 (VBUS), R11.1
unnamed: J3.A5 (CC1), R8.1
unnamed: J3.B5 (CC2), R7.1
unnamed: J4.1 (SWCLK), U1.33 (SWCLK)
unnamed: J4.3 (SWDIO), U1.34 (SWDIO)
unnamed: JP1.2, R5.1, U1.56 (GPIO45/ADC5)
unnamed: L1.2, U1.63 (VREG_LX)
unnamed: Q1.1 (G), R11.2, R12.1
unnamed: R1.2, U1.31 (XOUT)
unnamed: R2.1, SW1.2
unnamed: R2.2, U1.75 (~QSPI_SS)
unnamed: R3.2, SW2.2, U1.35 (RUN)
PSRAM_CS_N: R4.2, U1.58 (GPIO47/ADC7), U5.1 (~CE)
QSPI_SCLK: U1.71 (QSPI_SCLK), U5.6 (SCLK)
QSPI_SD0: U1.72 (QSPI_SD0), U5.5 (SI/SIO0)
QSPI_SD1: U1.74 (QSPI_SD1), U5.2 (SO/SIO1)
QSPI_SD2: U1.73 (QSPI_SD2), U5.3 (SIO2)
QSPI_SD3: U1.70 (QSPI_SD3), U5.7 (SIO3)
RESET_N: J1.37 (~RESET), J2.37 (~RESET), U1.48 (GPIO39)
RW: J1.30 (R/~W), J2.30 (R/~W), U1.38 (GPIO30)
USB_DM: J3.A7 (D-), J3.B7 (D-), R10.1, U4.2 (D-)
USB_DM_MCU: R10.2, U1.66 (USB_DM)
USB_DP: J3.A6 (D+), J3.B6 (D+), R9.1, U4.1 (D+)
USB_DP_MCU: R9.2, U1.67 (USB_DP)
USB_PRESENT_N: Q1.3 (D), R13.2, U1.57 (GPIO46/ADC6)
VPA_N: J1.39 (~VPA), J2.39 (~VPA), R16.1

Notes on the sheet:
PIO0: GPIO0-31; PIO1: GPIO16-47. Synchronization pending. J1 pin n = J2 pin n. RESET/HALT: LOW or release only. Target-only power / TTL bus. Mode interlock remains to be completed.
U5 shares QSPI clock/data with the 2 MiB in-package flash. GPIO47 = QMI CS1; GPIO46 = USB presence. R4 = 1k CS pull-up; C24/C25 at U5 VDD. Boot: wait 150us, reset PSRAM, then configure QMI. EPAD (pad 9) is left unconnected; see hardware notes.
BAT54X Vf margin accepted; see simulations/bat54/. MODE_PERMIT: GPIO45 permission input, default passive. USB_PRESENT_N: GPIO46 active-low VBUS detection. PSRAM_CS_N: GPIO47 QMI CS1; R4 is a 1k pull-up.
MCU local decoupling: place at supply pads
USB-C (target-powered)
48-pin MC68008 pass-through
SWD JST-SH: CLK / GND / IO
TOP CPU SOCKET (manual)
Target 5V / MCU supplies
3.3uH
Five protected inputs
MOTHERBOARD PLUG (manual)
C23: one shared J1/J2 bypass capacitor
8 MiB QSPI PSRAM
