MattisLind/68008ice/(commit log)

2026-11-07 Starting up the project.
    [68008ice.kicad_sch, bus_safety.kicad_sch, cpu_sockets.kicad_sch, cpu_translation.kicad_sch, fpga_core.kicad_sch, fpga_pins.csv, power_supply.kicad_sch, target_translation.kicad_sch]
2026-11-09 New approach based on RP2350.
    [68008ice.kicad_sch, bus_safety.kicad_sch, cpu_sockets.kicad_sch, cpu_translation.kicad_sch, fpga_core.kicad_sch, fpga_pins.csv, power_supply.kicad_sch, target_translation.kicad_sch]
2026-11-09 First schematic.
    [BOM.csv, BOM_JLCPCB.csv, mc68008_pinmap.csv, results.csv, rp2350_68008_ice.kicad_sch, rp2354b_gpio.csv]
2026-11-10 Changing type of BAT54, adding PSRAM, decision on debug connector.
    [BOM.csv, BOM_JLCPCB.csv, rp2350_68008_ice.kicad_sch, rp2354b_gpio.csv]
